gchicchi/Termometro_Micro/Estrutura_Mecânica.SLDPRT

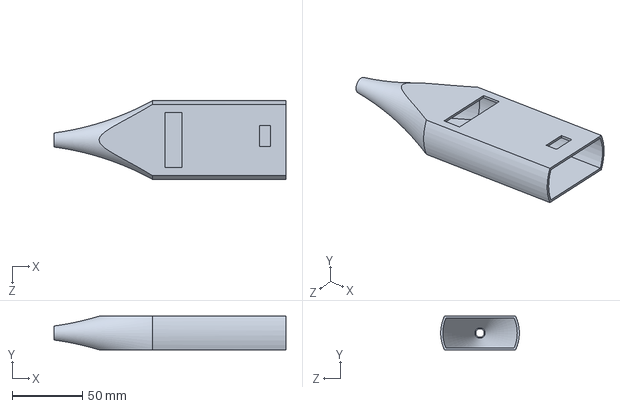
[picture p18: CAD file, 2026-06-28]
Estrutura_Mecânica.SLDPRT
165.0 x 24.0 x 56.0 mm
