gchicchi/Termometro_Micro/(list of files, drawings)

Other design files:
PCB_PCB_instrumentação_2026-06-28.json
