gchicchi/Termometro_Micro/build_ninja/pico-sdk/src/rp2_common/pico_cyw43_driver/pioasm/tmp/pioasmBuild-cfgcmd.txt

cmd='C:/Users/ggrun/.pico-sdk/cmake/v3.31.5/bin/cmake.exe;--no-warn-unused-cli;-DCMAKE_MAKE_PROGRAM:FILEPATH=C:/Users/ggrun/.pico-sdk/ninja/v1.12.1/ninja.exe;-DPIOASM_FLAT_INSTALL=1;-DCMAKE_INSTALL_PREFIX=C:/Users/ggrun/OneDrive/Documentos/Termometro/build_ninja/pioasm-install;-DCMAKE_RULE_MESSAGES=OFF;-DCMAKE_INSTALL_MESSAGE=NEVER;-GNinja;-C<TMP_DIR>/pioasmBuild-cache-$<CONFIG>.cmake;-S;<SOURCE_DIR><SOURCE_SUBDIR>;-B;<BINARY_DIR>'
