gchicchi/Termometro_Micro/build_ninja/pico-sdk/src/rp2_common/pico_cyw43_driver/pioasm/src/pioasmBuild-stamp/pioasmBuild-source_dirinfo.txt

# This is a generated file and its contents are an internal implementation detail.
# The download step will be re-executed if anything in this file changes.
# No other meaning or use of this file is supported.

method=source_dir
command=
source_dir=C:/Users/ggrun/.pico-sdk/sdk/2.2.0/tools/pioasm
work_dir=
